OmidMS/EPA-Robots/README.md

# EPA-Robots
Design of Low-Cost Modular Bio-Inspired Electric–Pneumatic Actuator (EPA)-Driven Legged Robots
