OmidMS/EPA-Robots/CAD/Step Files/Hip Axis.step

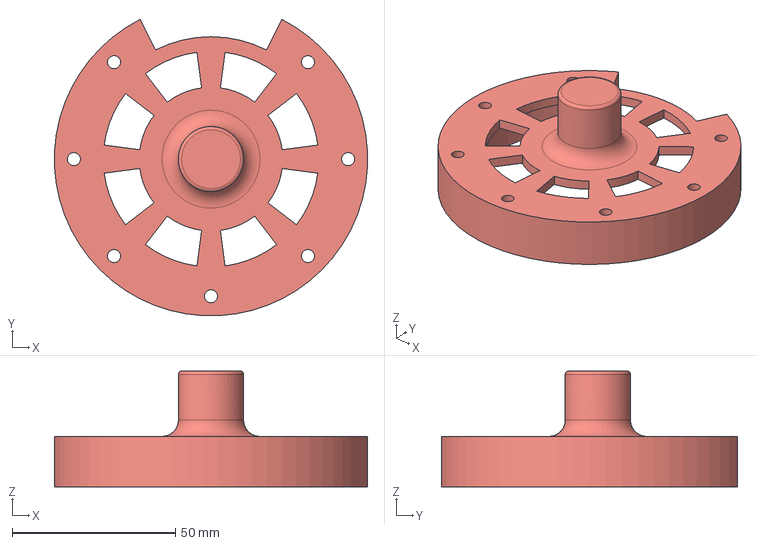
[picture p1: CAD file, 2024-04-19]
CAD/Step Files/Hip Axis.step
95.9 x 90.7 x 35.5 mm
