OmidMS/EPA-Robots/CAD/Step Files/Knee Hook.step

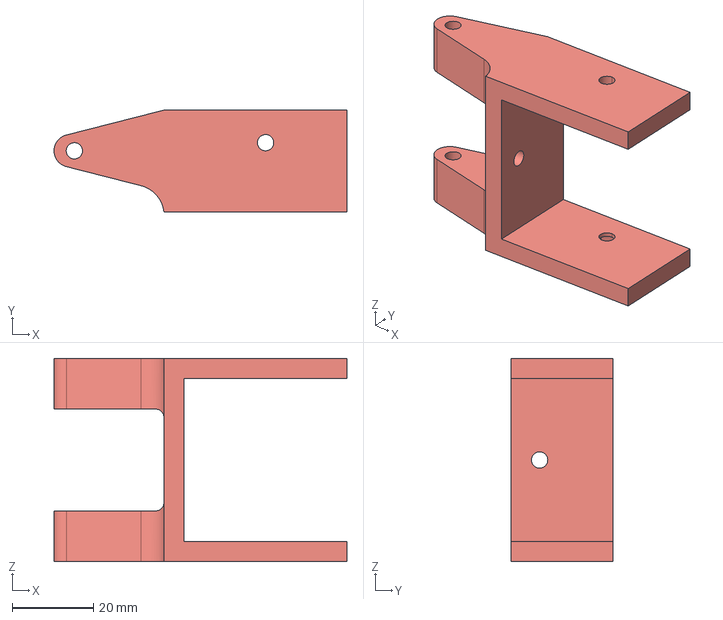
[picture p2: CAD file, 2024-04-19]
CAD/Step Files/Knee Hook.step
72.0 x 25.0 x 50.0 mm
