OmidMS/EPA-Robots/CAD/Step Files/Ankle.step

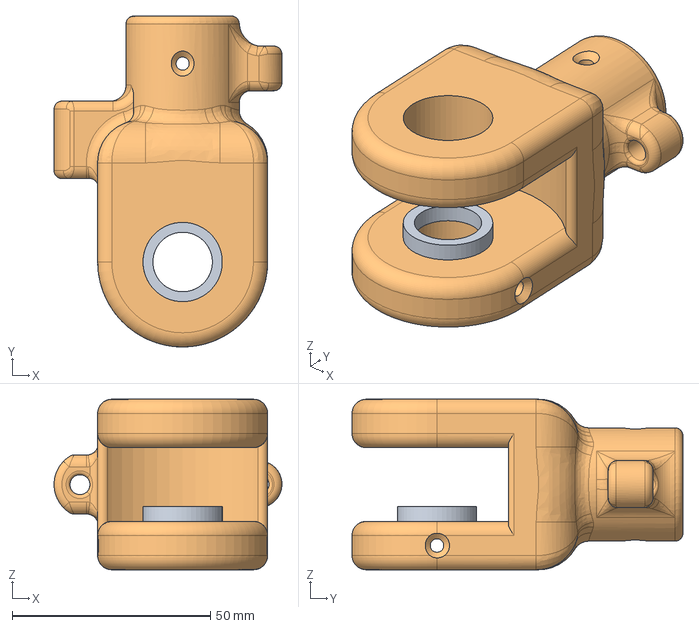
[picture p3: CAD file, 2024-04-19]
CAD/Step Files/Ankle.step
57.4 x 83.4 x 43.0 mm
