OmidMS/EPA-Robots/CAD/Step Files/Ball Bearing 6304-RS.step

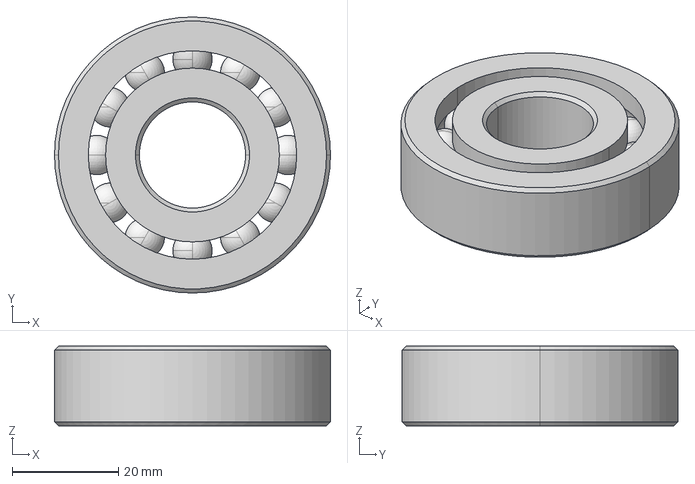
[picture p4: CAD file, 2024-04-19]
CAD/Step Files/Ball Bearing 6304-RS.step
52.0 x 52.0 x 15.0 mm
