OmidMS/EPA-Robots/CAD/Step Files/Knee Upper Pullley.step

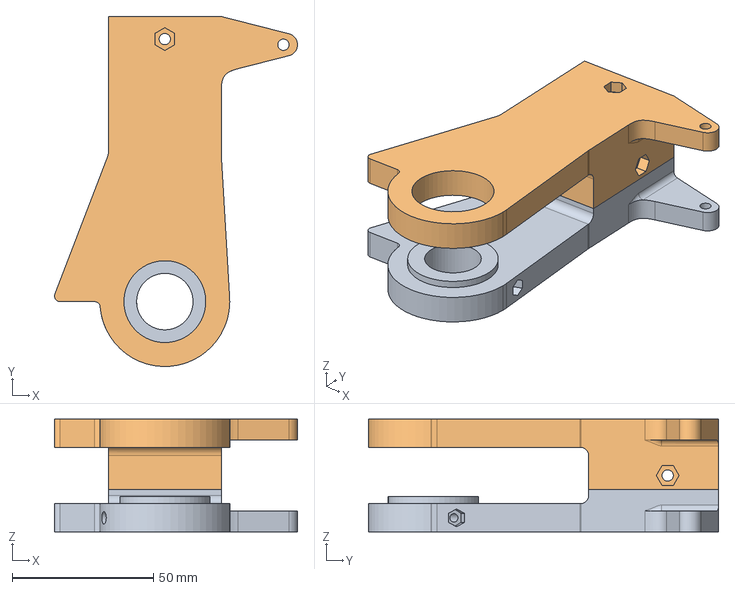
[picture p5: CAD file, 2024-04-19]
CAD/Step Files/Knee Upper Pullley.step
86.1 x 124.0 x 40.0 mm
