OmidMS/EPA-Robots/CAD/Step Files/Knee Lower Pulley.step

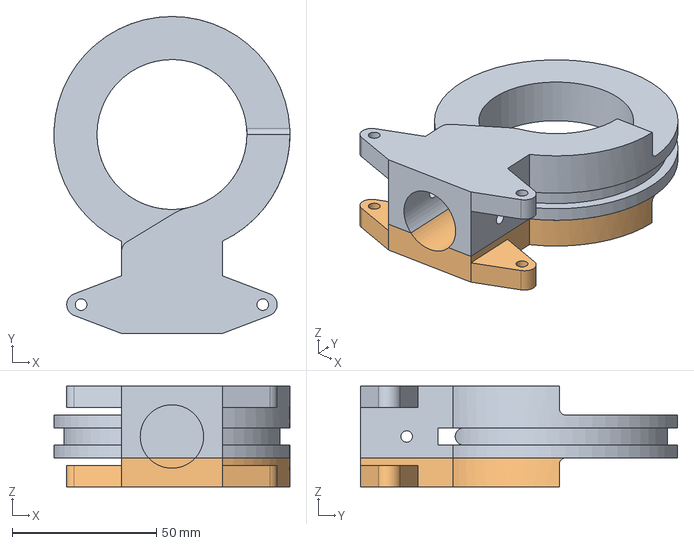
[picture p6: CAD file, 2024-04-19]
CAD/Step Files/Knee Lower Pulley.step
81.8 x 109.9 x 35.0 mm
