OmidMS/EPA-Robots/CAD/Step Files/Motor MIT.step

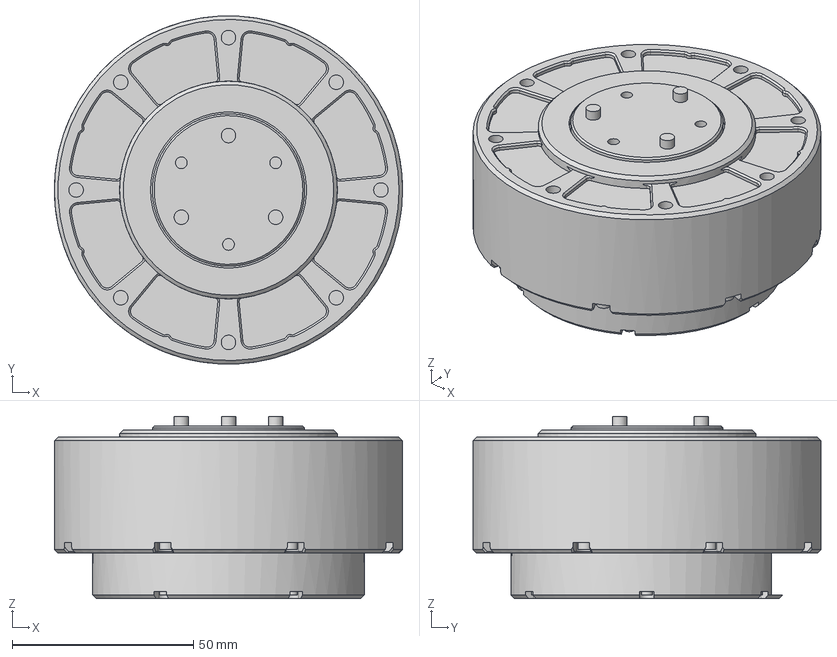
[picture p7: CAD file, 2024-04-19]
CAD/Step Files/Motor MIT.step
96.0 x 95.9 x 50.2 mm
