OmidMS/EPA-Robots/CAD/Step Files/Ball Bearing 6001-RS.step

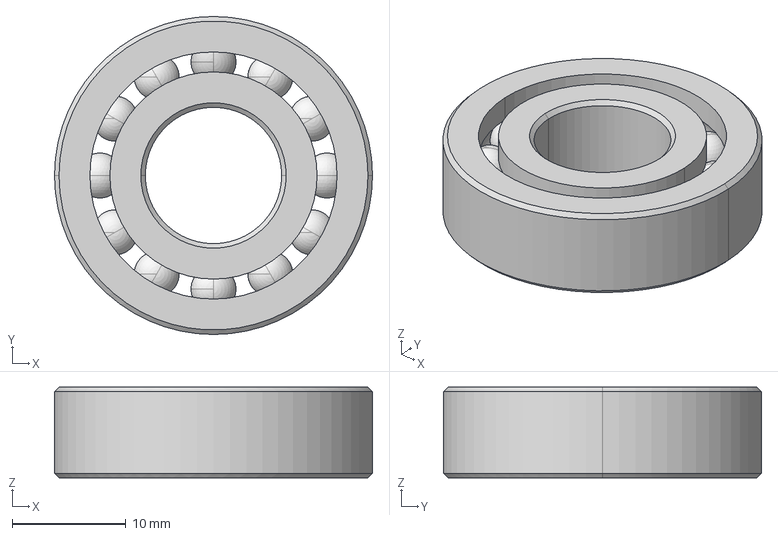
[picture p8: CAD file, 2024-04-19]
CAD/Step Files/Ball Bearing 6001-RS.step
28.0 x 28.0 x 8.00 mm
