OmidMS/EPA-Robots/CAD/Step Files/Hip.step

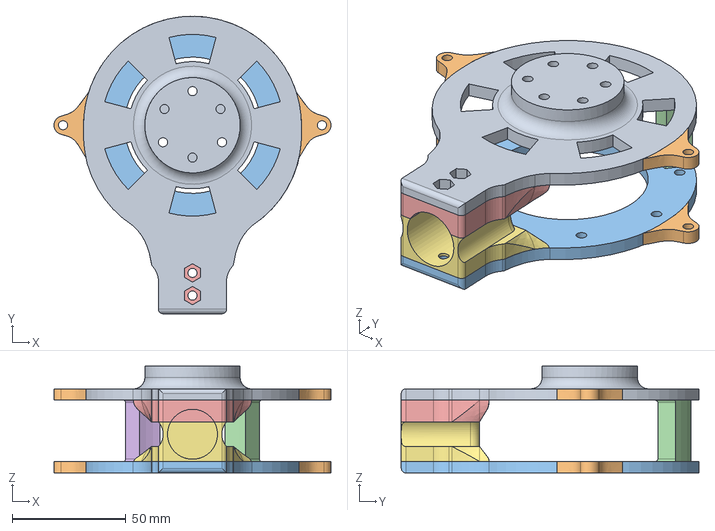
[picture p9: CAD file, 2024-04-19]
CAD/Step Files/Hip.step
122.0 x 131.0 x 47.0 mm
