OmidMS/EPA-Robots/CAD/Step Files/Knee Axis.step

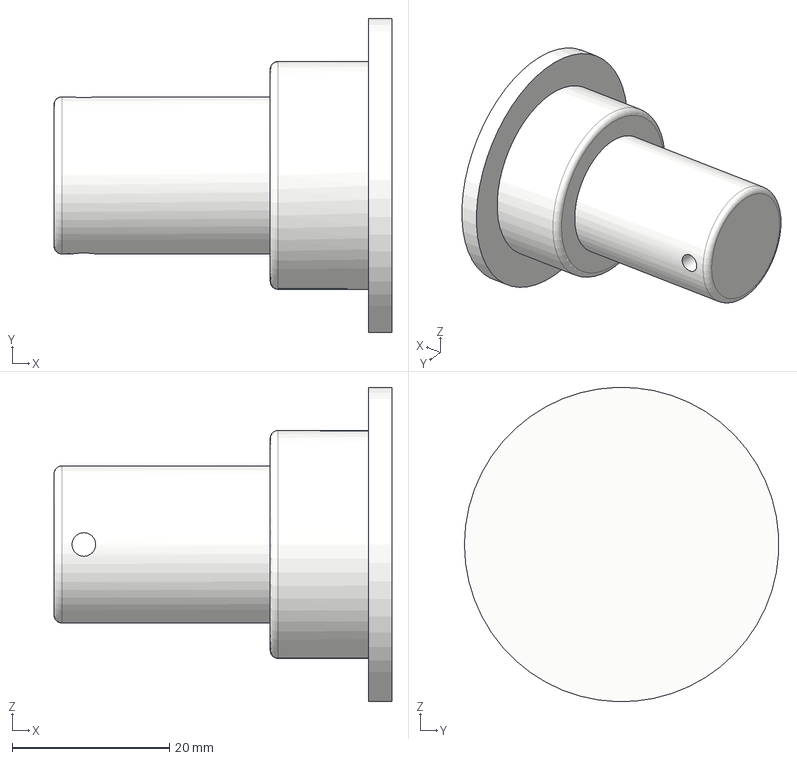
[picture p10: CAD file, 2024-04-19]
CAD/Step Files/Knee Axis.step
43.0 x 40.0 x 40.0 mm
