OmidMS/EPA-Robots/CAD/Step Files/Ball Bearing 6202-2Z.step

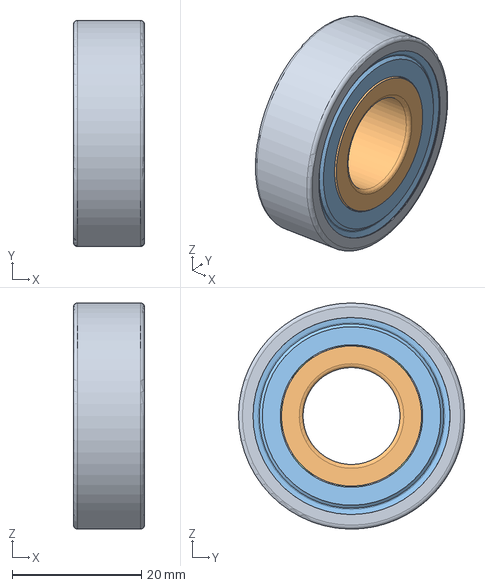
[picture p11: CAD file, 2024-04-19]
CAD/Step Files/Ball Bearing 6202-2Z.step
11.0 x 35.0 x 35.0 mm
