OmidMS/EPA-Robots/CAD/Step Files/Ankle Axis.step

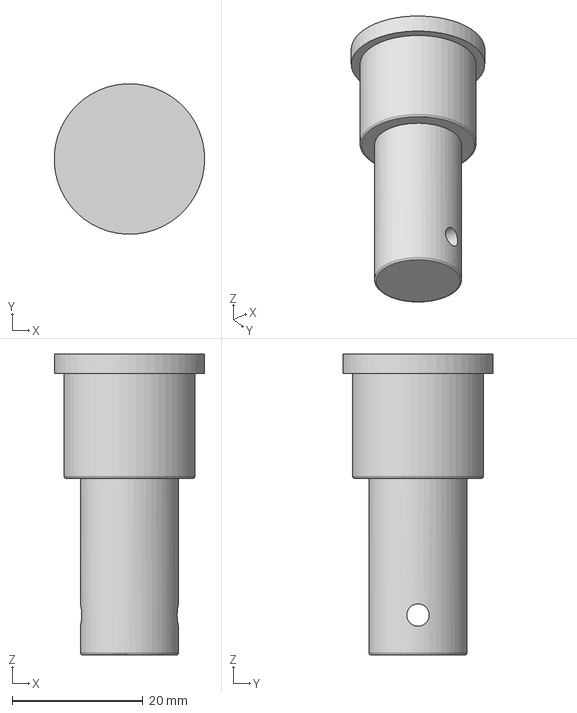
[picture p12: CAD file, 2024-04-19]
CAD/Step Files/Ankle Axis.step
23.0 x 23.0 x 46.0 mm
