OmidMS/EPA-Robots/(list of files, cad)

Other CAD files:
CAD/Fusion Files/Ankle Axis.f3d
CAD/Fusion Files/Ankle.f3d
CAD/Fusion Files/Ball Bearing 6001-RS.f3d
CAD/Fusion Files/Ball Bearing 6202-2Z.f3d
CAD/Fusion Files/Ball Bearing 6304-RS.f3d
CAD/Fusion Files/EPA Walker Trunk Union/JumperTrunk_BottomTop v8.f3d
CAD/Fusion Files/Foot.f3d
CAD/Fusion Files/Hip Axis.f3d
CAD/Fusion Files/JumperTrunk_BottomPlate_4mm v6.f3d
CAD/Fusion Files/JumperTrunk_MidPlates v2.f3d
CAD/Fusion Files/JumperTrunk_TopPlate_4mm v2.f3d
CAD/Fusion Files/Knee Axis.f3d
CAD/Fusion Files/Knee Hook.f3d
CAD/Fusion Files/Knee Lower Pulley.f3z
CAD/Fusion Files/Knee Upper Pullley.f3d
CAD/Fusion Files/Motor MIT.f3d
CAD/Fusion Files/Trunk Assembly.f3z
CAD/Fusion Files/Trunk Side Plates v2.f3d
