OmidMS/EPA-Robots/EPA Jumper Guide 8780db8f66b24e0d9287d5adcf2fbd1b/CAD f8400f0d7d7a47449e0f20deaf9393d1.html

# CAD

All the CAD files from the robot shared in Fusion File Fomat (.f3d .f3z) and in STEP format (.step). Each piece is presented on the diagram below and they are detailed on the list.

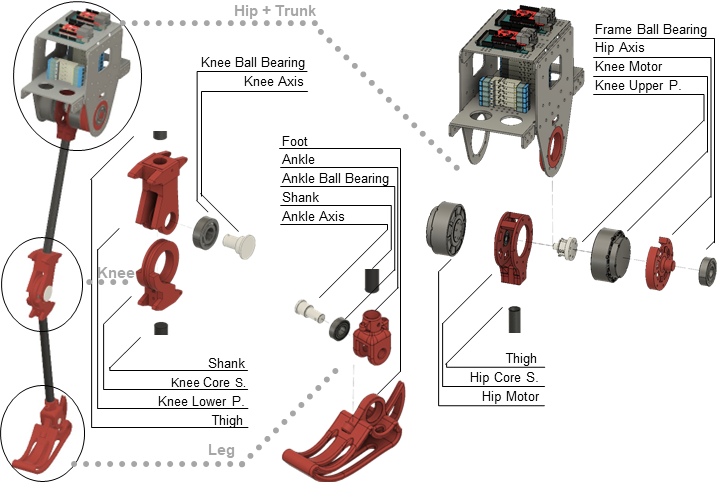
[picture p13: EPA Jumper Guide 8780db8f66b24e0d9287d5adcf2fbd1b/CAD f8400f0d7d7a47449e0f20deaf9393d1/Draft4.png]


# File Documentation

1. Assemblies
  a. EPA Assembly
    - Assembly from the whole leg and trunk.
  b. Trunk Assembly
    - Assembly from the trunk with all subparts.
2. 3D printed parts
  a. Ankle + Foot Parts
    i. Ankle
    ii. Foot
    iii. Ankle Axis
  b. Knee Parts
    i. Knee Upper Pulley
    ii. Knee Hook
    iii. Knee Lower Pulley
    iv. Knee Axis
  c. Hip Parts
    i. Hip
    ii. Hip Axis
3. Auxiliary Parts
  a. Motor MIT
  b. Ball Bearing 6001-RS
  c. Ball Bearing 6202-2Z
  d. Ball Bearing 6304-RS
